OmerErtekin/Table-Assistent/README.md

# Table-Assistent
This project made for INF-340 Microprosessors cours with Akifcan Özbulut
